mihaicuciuc/iceCube/Case/iceCubeCase.stl

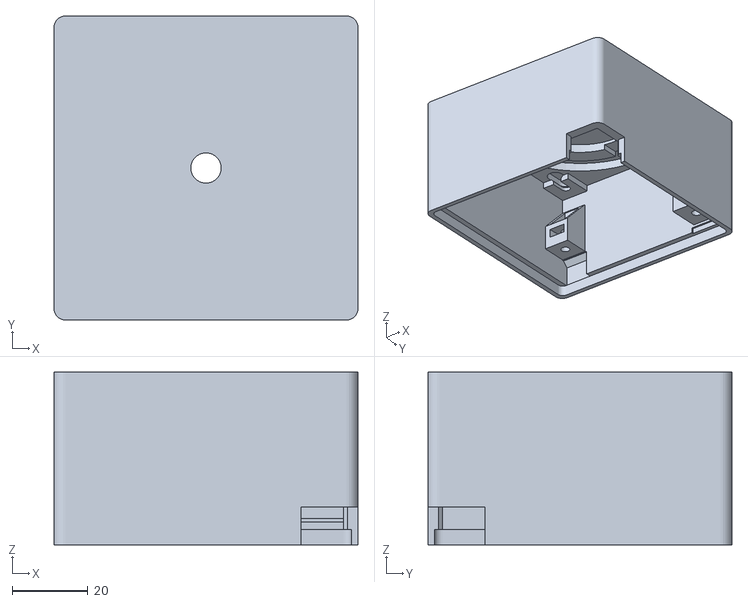
[picture p1: CAD file, 2020-05-11]
Case/iceCubeCase.stl
80.0 x 80.0 x 45.5
