mihaicuciuc/iceCube/Case/iceCube.FCStd

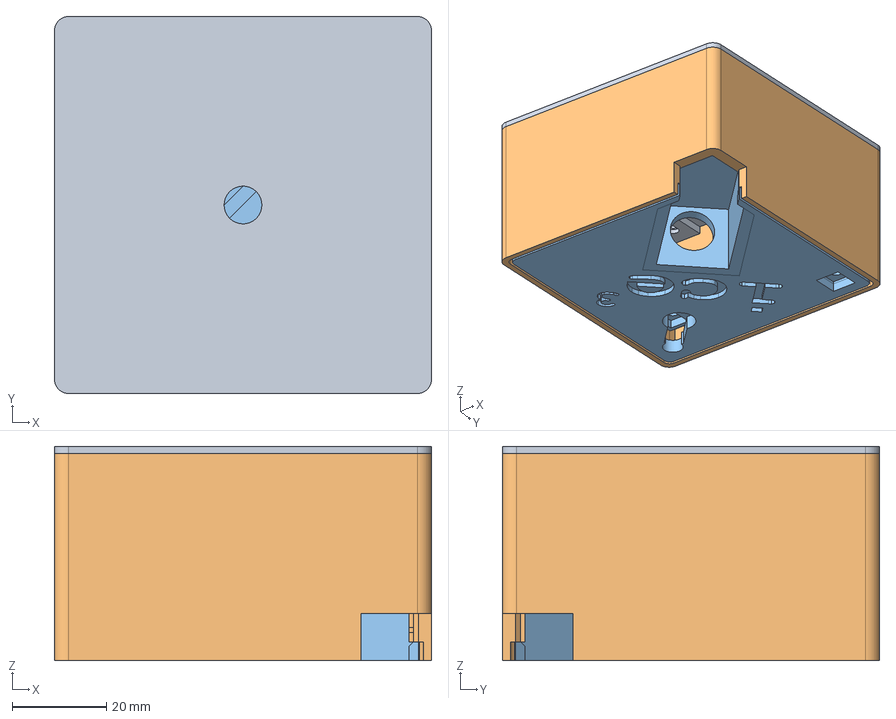
[picture p2: CAD file, 2020-05-11]
Case/iceCube.FCStd
80.0 x 80.0 x 45.5 mm
ClockFace
Sides
