mihaicuciuc/iceCube/Case/iceCubeBack.stl

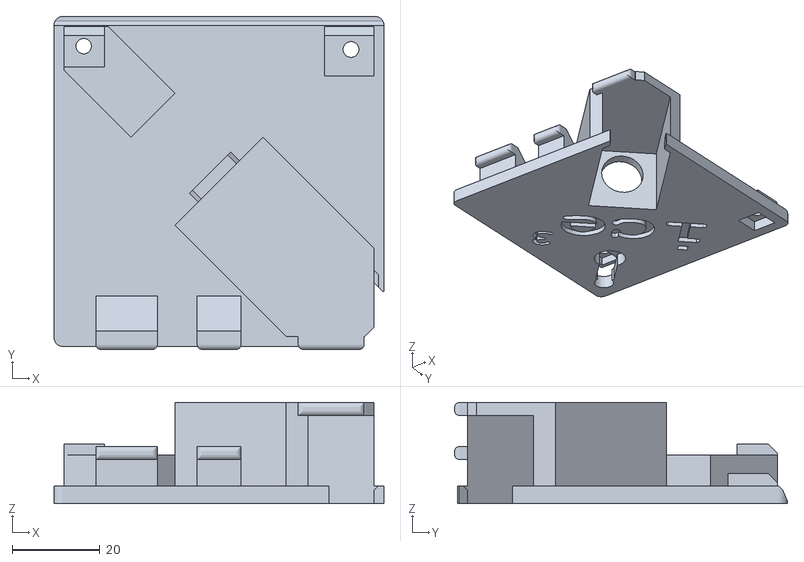
[picture p3: CAD file, 2020-05-11]
Case/iceCubeBack.stl
75.0 x 75.7 x 23.0
