mihaicuciuc/iceCube/PCB/iceCube.kicad_pcb

## KiCad design PCB/iceCube.kicad_pcb (2020-05-11)

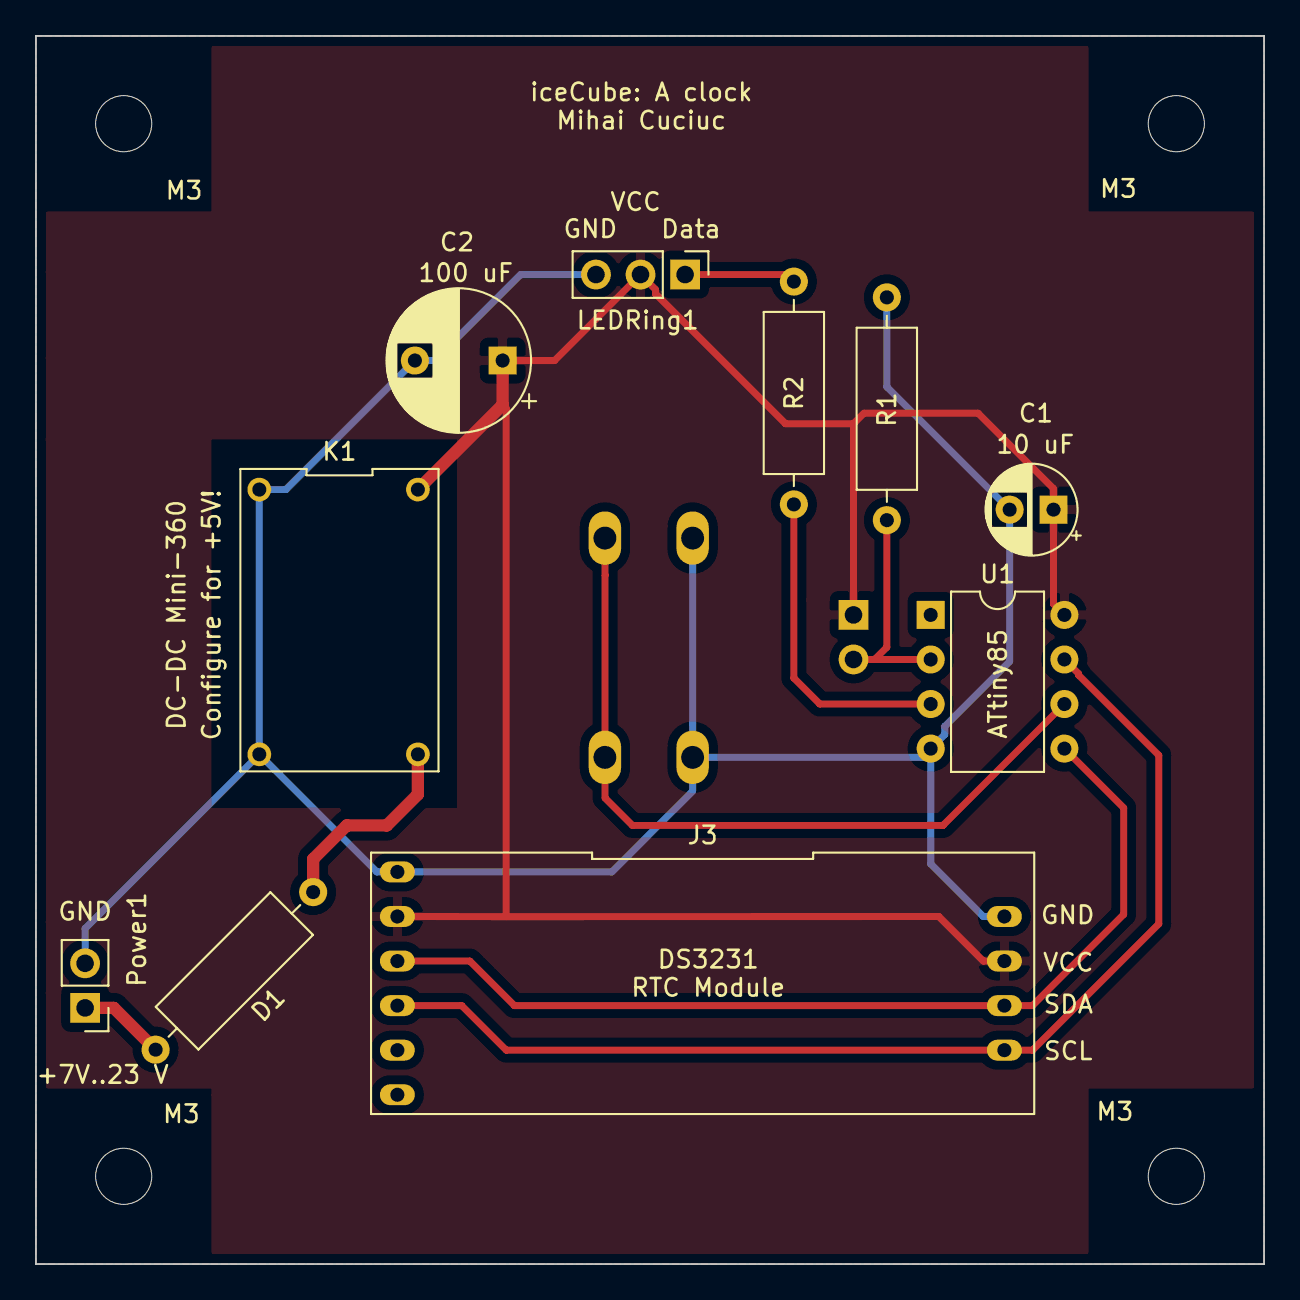
[picture p4: board iceCube.kicad_pcb from above]

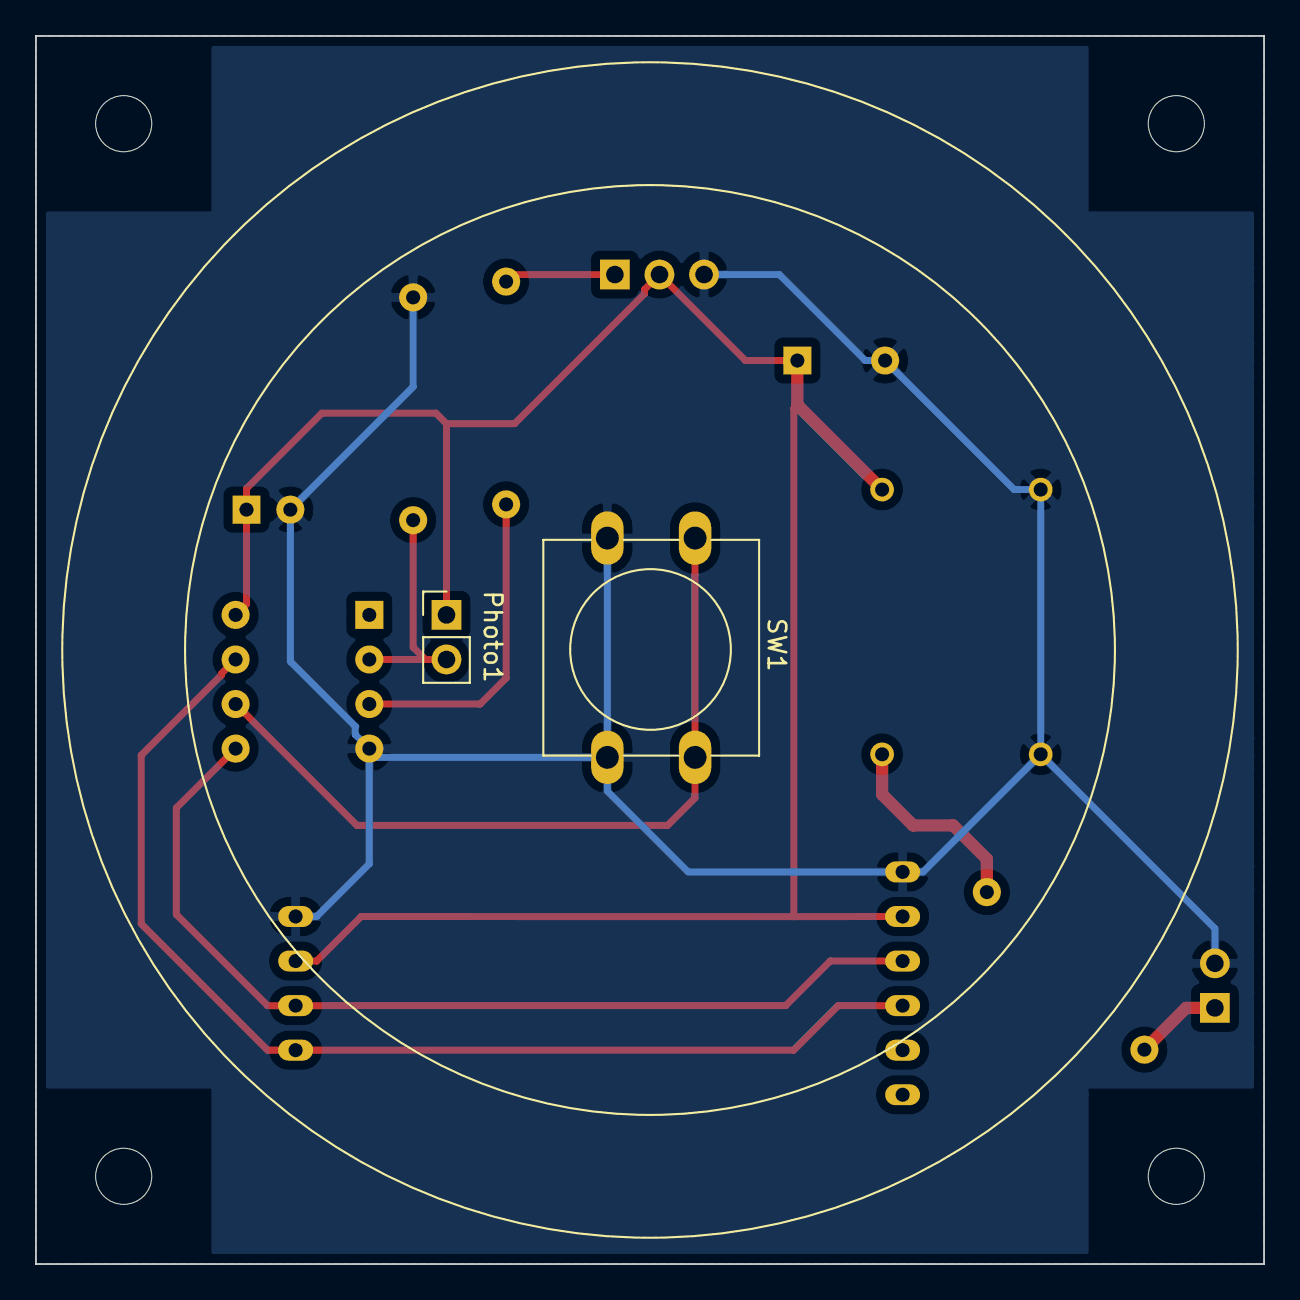
[picture p5: board iceCube.kicad_pcb from below]

Board: 2 copper layers, 70.0 x 70.0 mm, 16 parts (2 on the bottom side), 10 nets.

Parts:
C1: 10uF; CP_Radial_D5.0mm_P2.50mm
C2: 100uF; CP_Radial_D8.0mm_P5.00mm
D1: 1N4001; R_Axial_DIN0309_L9.0mm_D3.2mm_P12.70mm_Horizontal
J3: RTC; RTC_Module
K1: DC_DC_Mini-360
LEDRing1: LEDs; PinHeader_1x03_P2.54mm_Vertical
M3, M3#2, M3#3, M3#4: MountingHole_3.2mm_M3
Photo1: R_PHOTO; PinHeader_1x02_P2.54mm_Vertical
Power1: Power; PinHeader_1x02_P2.54mm_Vertical
R1: 75K; R_Axial_DIN0309_L9.0mm_D3.2mm_P12.70mm_Horizontal
R2: 300R; R_Axial_DIN0309_L9.0mm_D3.2mm_P12.70mm_Horizontal
SW1: SW_Push; SW_PUSH-12mm
U1: ATtiny85-20PU; DIP-8_W7.62mm

Connections:
+5V: C1.1, C2.1, J3.2, K1.4, LEDRing1.2, Photo1.1, U1.8
GNDD: C1.2, C2.2, J3.1, K1.1, K1.2, LEDRing1.3, Power1.2, R1.2, SW1.2, U1.4
unnamed: D1.1, K1.3
unnamed: D1.2, Power1.1
unnamed: J3.3, U1.5
unnamed: J3.4, U1.7
unnamed: LEDRing1.1, R2.1
unnamed: Photo1.2, R1.1, U1.2
unnamed: R2.2, U1.3
unnamed: SW1.1, U1.6
